LeonLeibbrandt/stm32f103-dro/kicad-B_Cu.png

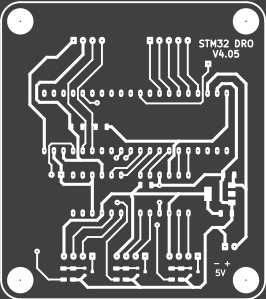
kicad-B_Cu.png
