LeonLeibbrandt/stm32f103-dro/3dobjects/150mm/CaliperHead.FCStd

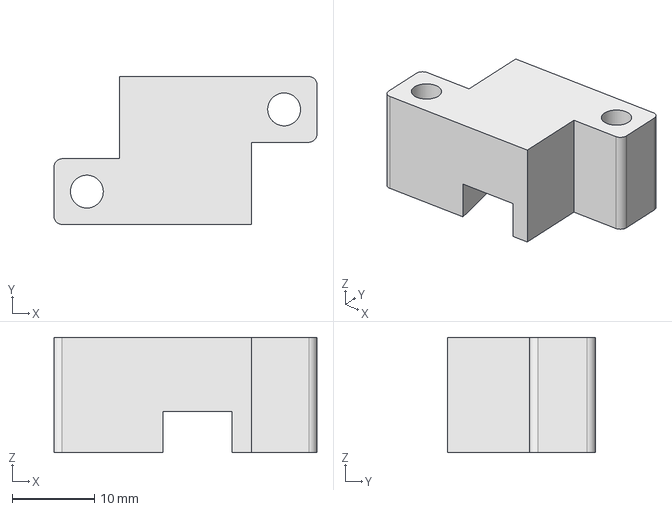
[picture p2: CAD file, 2023-06-25]
3dobjects/150mm/CaliperHead.FCStd
32.0 x 18.0 x 14.0 mm
