LeonLeibbrandt/stm32f103-dro/3dobjects/200mm/CaliperHeads.FCStd

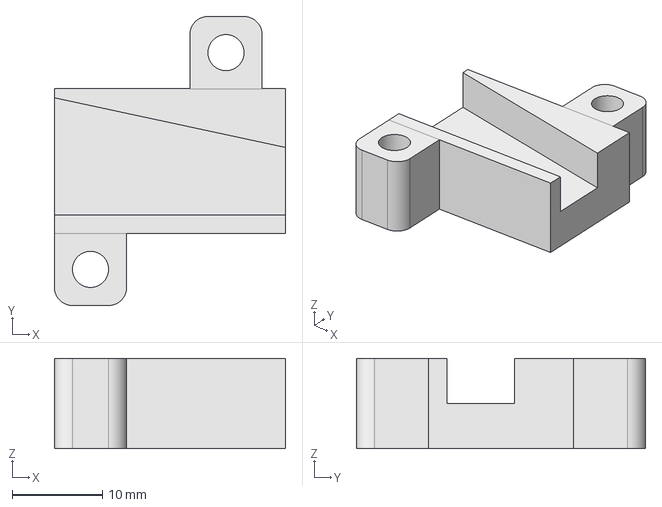
[picture p3: CAD file, 2022-05-27]
3dobjects/200mm/CaliperHeads.FCStd
25.6 x 32.0 x 10.0 mm
