LeonLeibbrandt/stm32f103-dro/3dobjects/300mm/CaliperHeads.FCStd

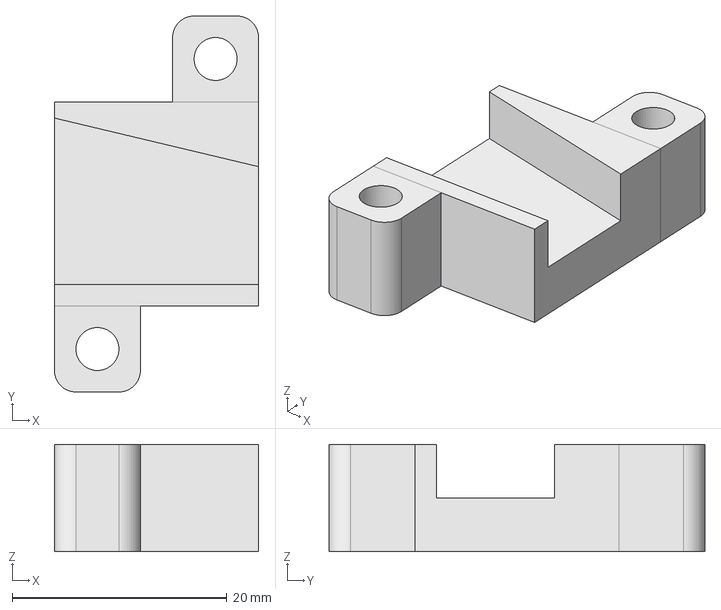
[picture p4: CAD file, 2022-05-27]
3dobjects/300mm/CaliperHeads.FCStd
19.0 x 35.0 x 10.0 mm
