LeonLeibbrandt/stm32f103-dro/3dobjects/box/dro.FCStd

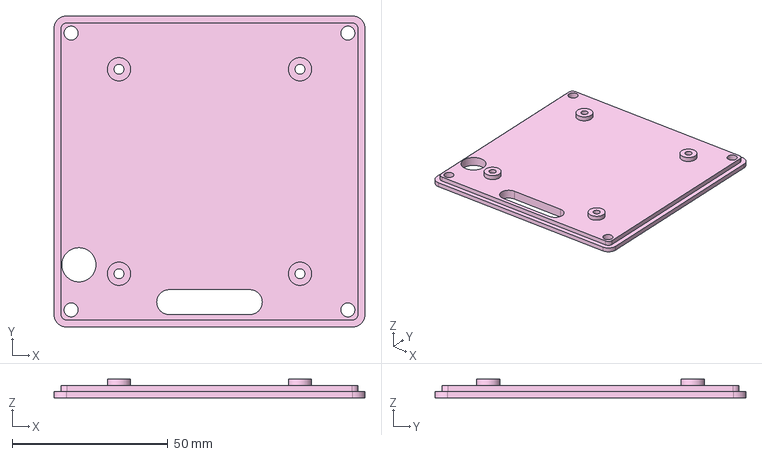
[picture p5: CAD file, 2022-11-13]
3dobjects/box/dro.FCStd
100.0 x 100.0 x 6.00 mm
