LeonLeibbrandt/stm32f103-dro/kicad/3dmodels/Tactile Push Button THT 12x12mm H8.50mm (Würth 430476085716).stp

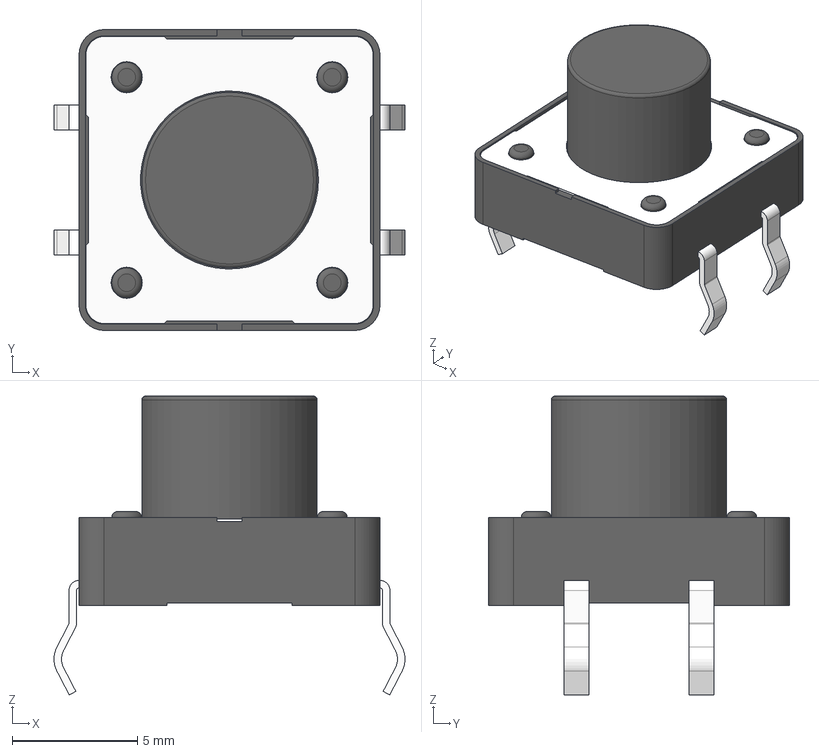
[picture p6: CAD file, 2022-05-27]
kicad/3dmodels/Tactile Push Button THT 12x12mm H8.50mm (Würth 430476085716).stp
14.0 x 12.0 x 11.9 mm
