LeonLeibbrandt/stm32f103-dro/3dobjects/150mm/CaliperHolder.FCStd

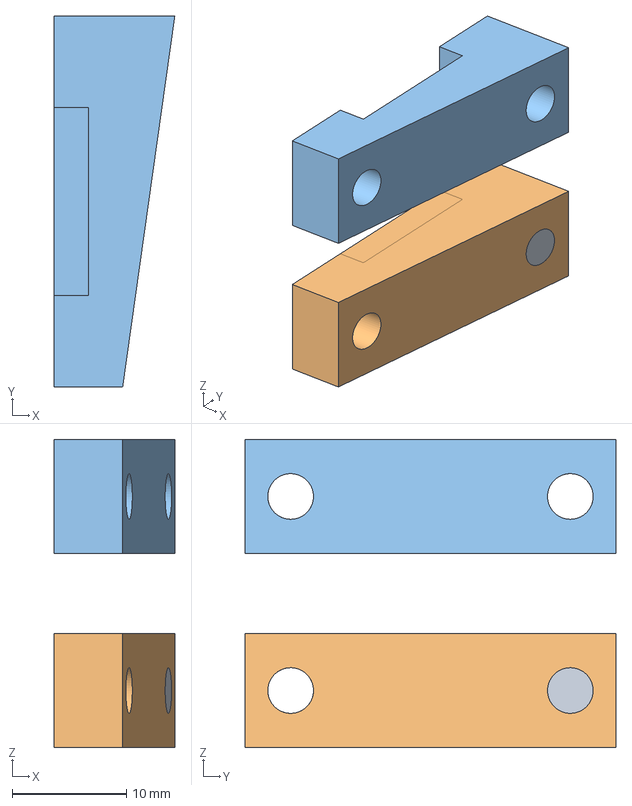
[picture p7: CAD file, 2023-06-25]
3dobjects/150mm/CaliperHolder.FCStd
10.6 x 32.5 x 27.0 mm
