LeonLeibbrandt/stm32f103-dro/3dobjects/200mm/CaliperMount.FCStd

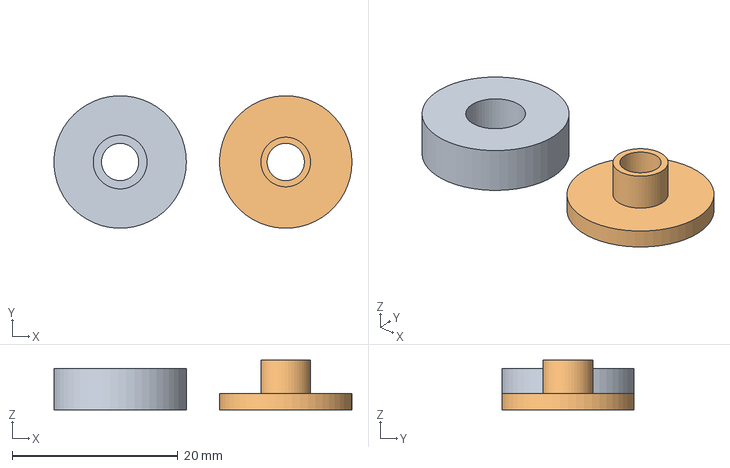
[picture p8: CAD file, 2022-05-27]
3dobjects/200mm/CaliperMount.FCStd
36.0 x 16.0 x 6.00 mm
Cap
