LeonLeibbrandt/stm32f103-dro/3dobjects/300mm/Caliper300mmEndCap.FCStd

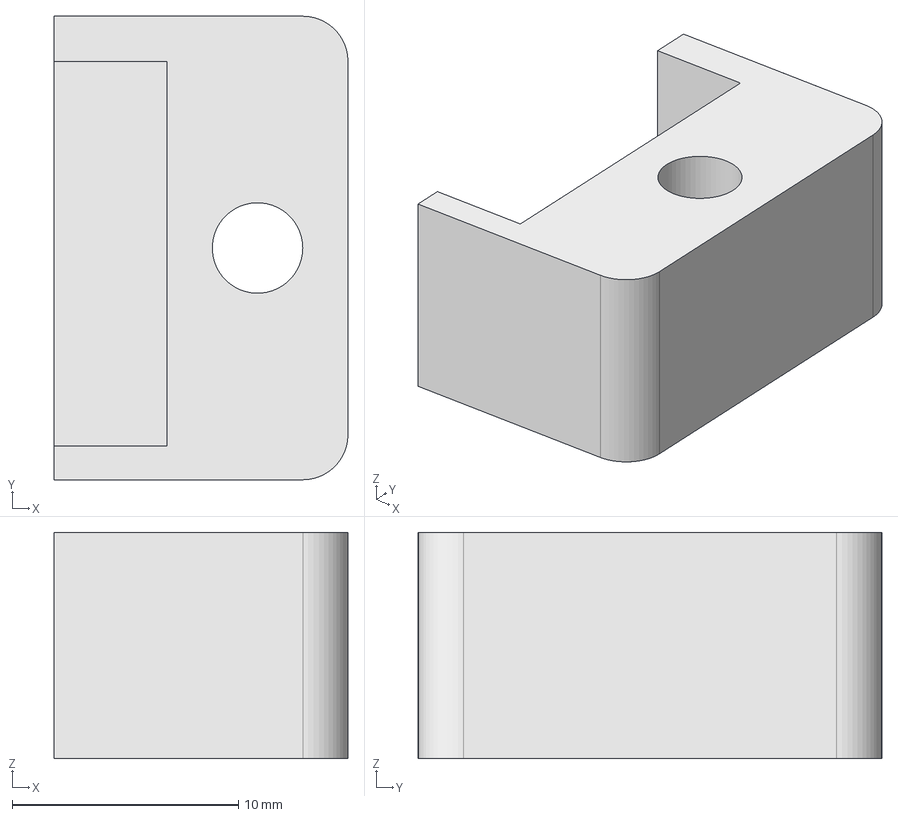
[picture p9: CAD file, 2022-05-27]
3dobjects/300mm/Caliper300mmEndCap.FCStd
13.0 x 20.5 x 10.0 mm
