LeonLeibbrandt/stm32f103-dro/3dobjects/150mm/CaliperHeads.FCStd

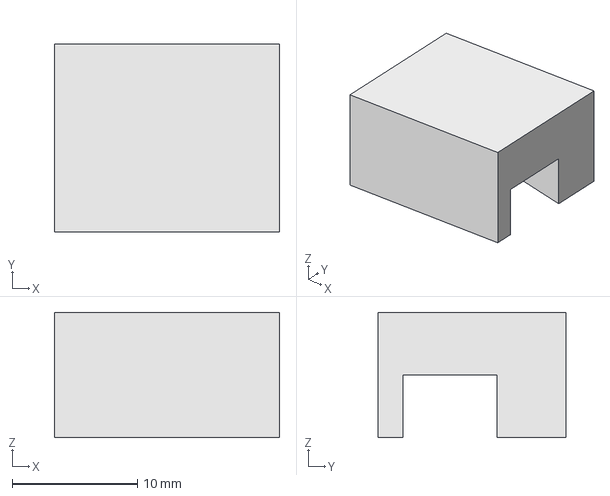
[picture p10: CAD file, 2022-05-27]
3dobjects/150mm/CaliperHeads.FCStd
18.0 x 15.0 x 10.0 mm
