LeonLeibbrandt/stm32f103-dro/kicad/main/kicad.kicad_pcb

## KiCad design kicad/main/kicad.kicad_pcb (2024-09-24)

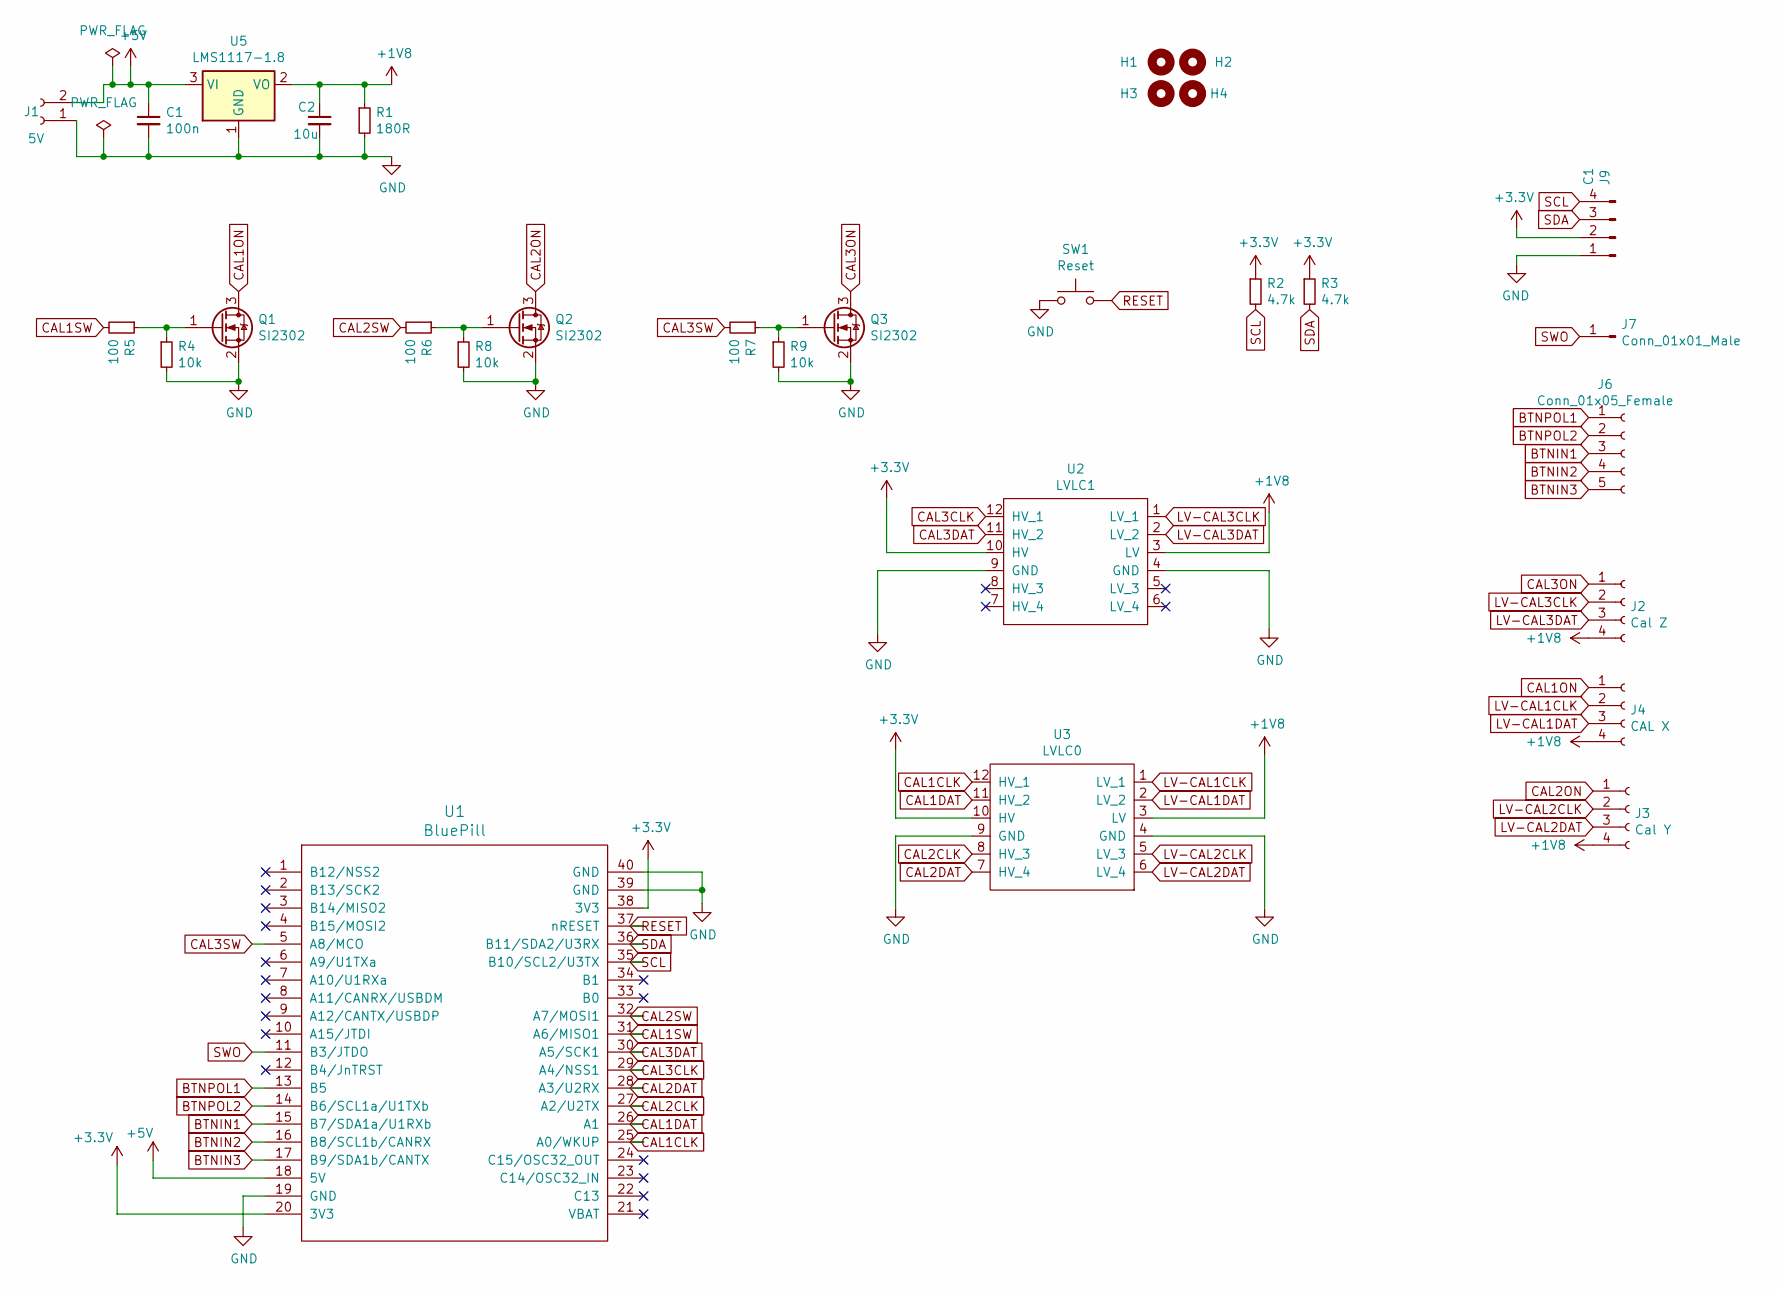
[picture p11: schematic kicad.kicad_sch]

Parts:
C1: 100n; C_1206_3216Metric
C2: 10u; C_1206_3216Metric
H1, H2, H3, H4: MountingHole; MountingHole_3.5mm_Pad
J1: 5V; JST_XH_B2B-XH-A_1x02_P2.50mm_Vertical
J2: Cal Z; JST_XH_B4B-XH-A_1x04_P2.50mm_Vertical
J3: Cal Y; JST_XH_B4B-XH-A_1x04_P2.50mm_Vertical
J4: CAL X; JST_XH_B4B-XH-A_1x04_P2.50mm_Vertical
J6: Conn_01x05_Female; JST_XH_B5B-XH-A_1x05_P2.50mm_Vertical
J7: Conn_01x01_Male; PinHeader_1x01_P2.54mm_Horizontal
J9: C1; JST_XH_B4B-XH-A_1x04_P2.50mm_Vertical
Q1, Q2, Q3: SI2302; SOT-23
R1: 180R; R_1206_3216Metric
R2, R3: 4.7k; R_1206_3216Metric
R4, R8, R9: 10k; R_1206_3216Metric
R5, R6, R7: 100; R_1206_3216Metric
SW1: Reset; PinHeader_1x02_P2.54mm_Vertical
U1: BluePill; bluepill
U2: LVLC1; levelconverter
U3: LVLC0; levelconverter
U5: LMS1117-1.8; SOT-223-3_TabPin2

Connections:
+1V8: C2.1, J2.4, J3.4, J4.4, R1.1, U2.3 (LV), U3.3 (LV), U5.2 (VO)
+3V3: J9.2, R2.1, R3.1, U1.20 (3V3), U1.38 (3V3), U2.10 (HV), U3.10 (HV)
+5V: C1.1, J1.2, U1.18 (5V), U5.3 (VI)
BTNIN1: J6.3, U1.15 (B7/SDA1a/U1RXb)
BTNIN2: J6.4, U1.16 (B8/SCL1b/CANRX)
BTNIN3: J6.5, U1.17 (B9/SDA1b/CANTX)
BTNPOL1: J6.1, U1.13 (B5)
BTNPOL2: J6.2, U1.14 (B6/SCL1a/U1TXb)
CAL1CLK: U1.25 (A0/WKUP), U3.12 (HV_1)
CAL1DAT: U1.26 (A1), U3.11 (HV_2)
CAL1ON: J4.1, Q1.3 (D)
CAL1SW: R5.2, U1.31 (A6/MISO1)
CAL2CLK: U1.27 (A2/U2TX), U3.8 (HV_3)
CAL2DAT: U1.28 (A3/U2RX), U3.7 (HV_4)
CAL2ON: J3.1, Q2.3 (D)
CAL2SW: R6.2, U1.32 (A7/MOSI1)
CAL3CLK: U1.29 (A4/NSS1), U2.12 (HV_1)
CAL3DAT: U1.30 (A5/SCK1), U2.11 (HV_2)
CAL3ON: J2.1, Q3.3 (D)
CAL3SW: R7.2, U1.5 (A8/MCO)
GND: C1.2, C2.2, J1.1, J9.1, Q1.2 (S), Q2.2 (S), Q3.2 (S), R1.2, R4.2, R8.2, R9.2, SW1.1, U1.19 (GND), U1.39 (GND), U1.40 (GND), U2.4 (GND), U2.9 (GND), U3.4 (GND), U3.9 (GND), U5.1 (GND)
LV-CAL1CLK: J4.2, U3.1 (LV_1)
LV-CAL1DAT: J4.3, U3.2 (LV_2)
LV-CAL2CLK: J3.2, U3.5 (LV_3)
LV-CAL2DAT: J3.3, U3.6 (LV_4)
LV-CAL3CLK: J2.2, U2.1 (LV_1)
LV-CAL3DAT: J2.3, U2.2 (LV_2)
unnamed: Q1.1 (G), R4.1, R5.1
unnamed: Q2.1 (G), R6.1, R8.1
unnamed: Q3.1 (G), R7.1, R9.1
RESET: SW1.2, U1.37 (nRESET)
SCL: J9.4, R2.2, U1.35 (B10/SCL2/U3TX)
SDA: J9.3, R3.2, U1.36 (B11/SDA2/U3RX)
SWO: J7.1, U1.11 (B3/JTDO)

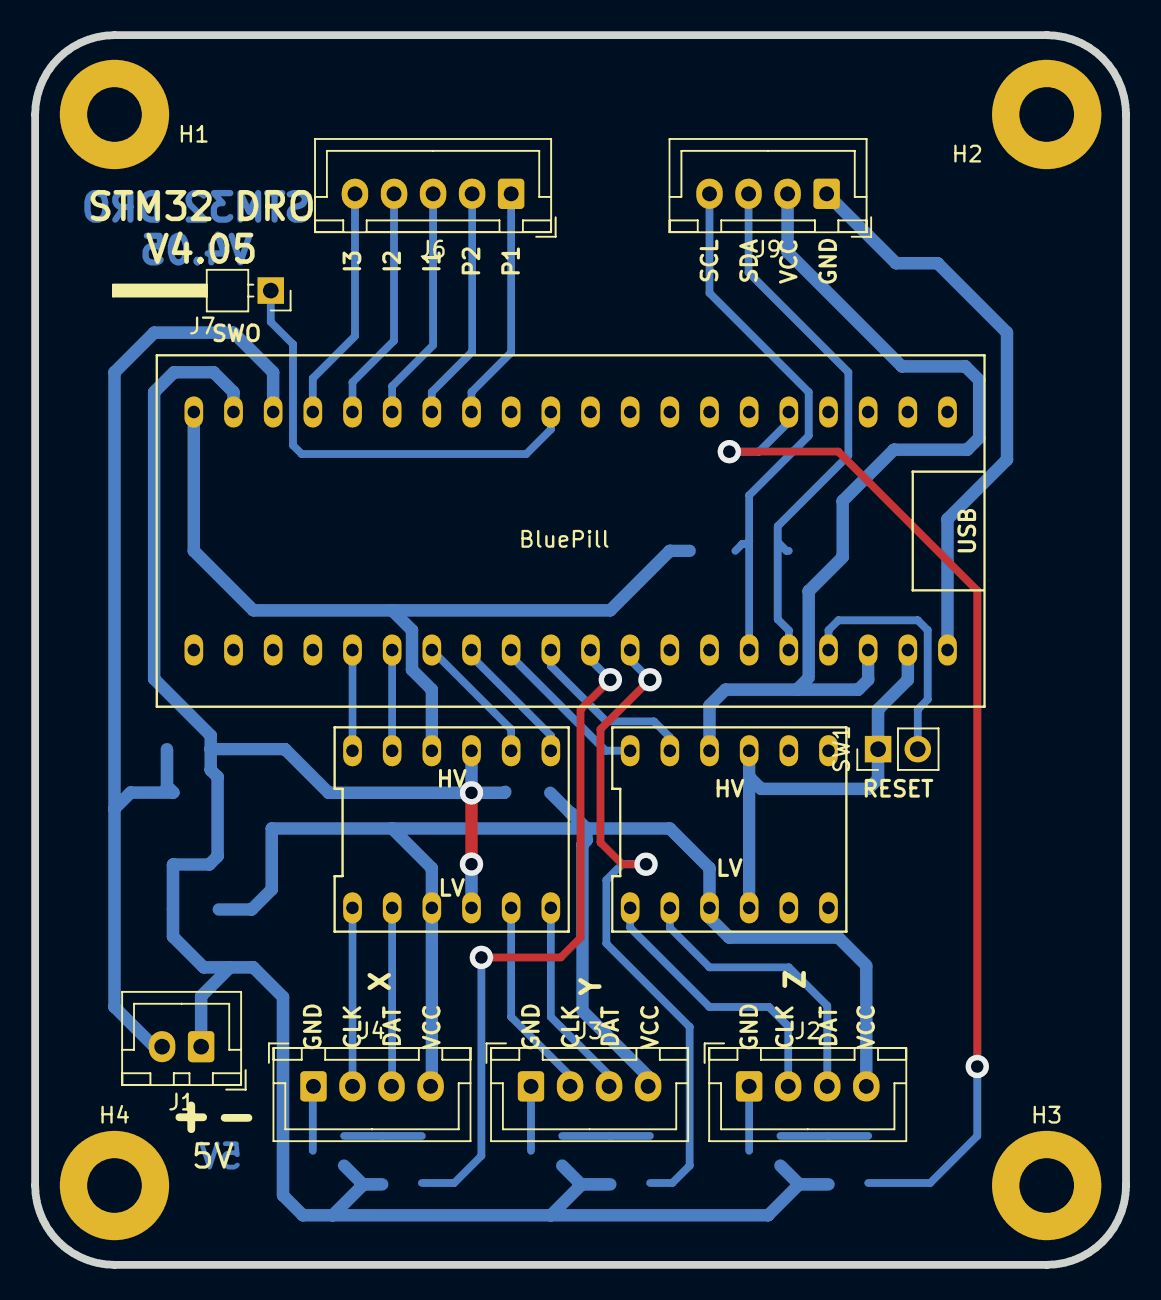
[picture p12: board kicad.kicad_pcb from above]

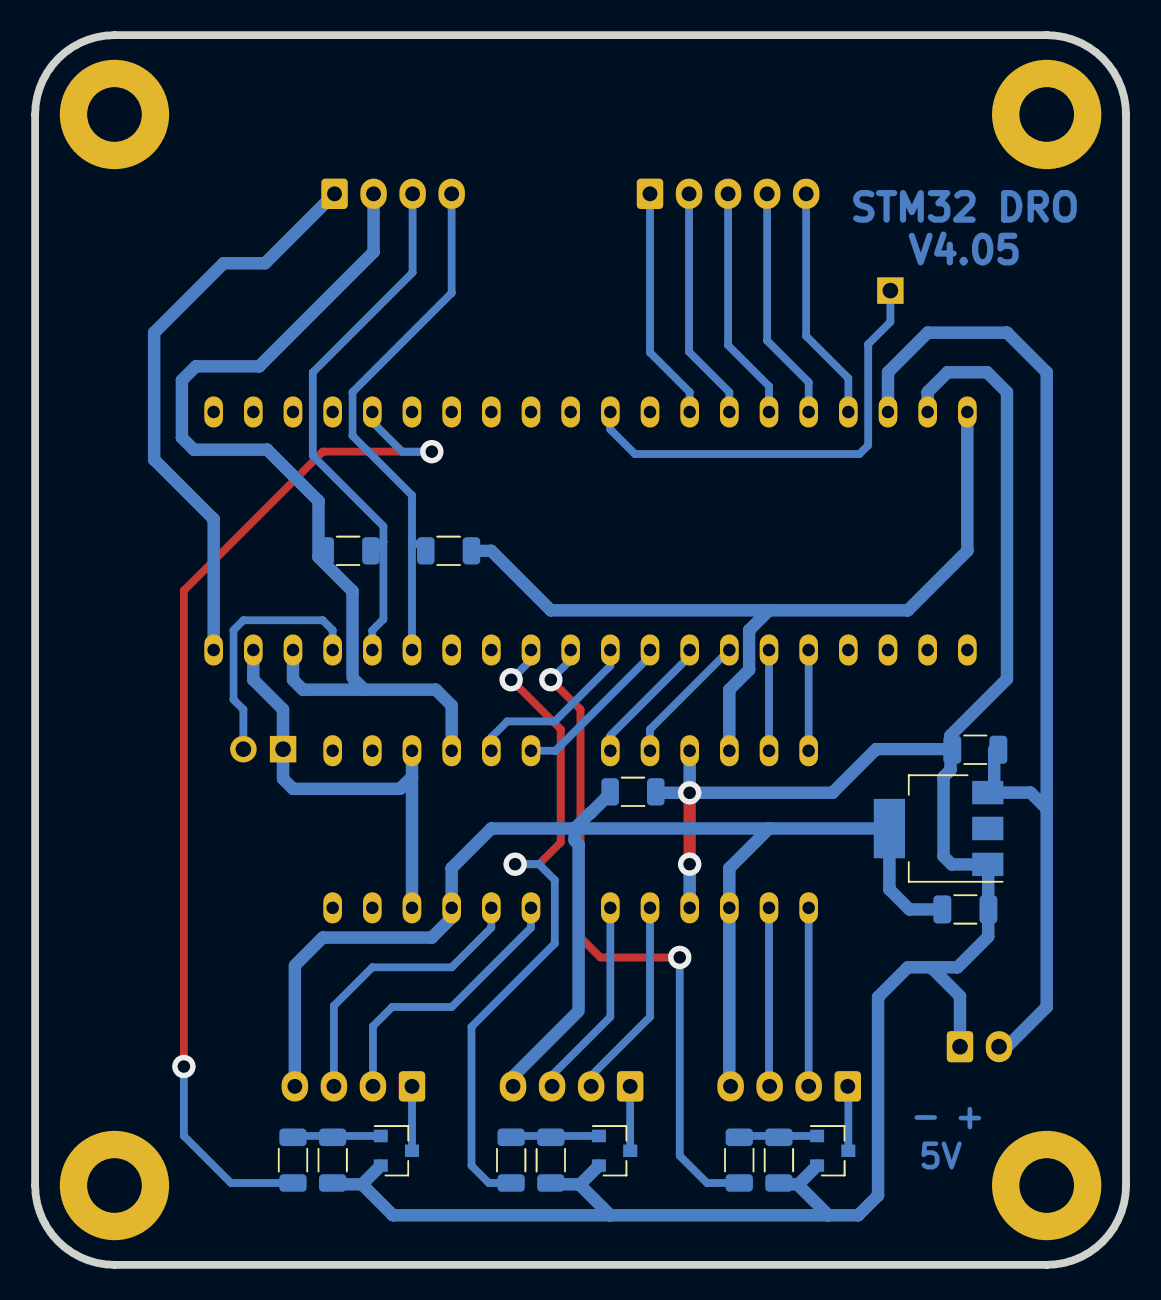
[picture p13: board kicad.kicad_pcb from below]

Board: 2 copper layers, 69.8 x 78.7 mm, 30 parts (15 on the bottom side), 34 nets.
