LeonLeibbrandt/stm32f103-dro/kicad/interface/interface.kicad_pcb

## KiCad design kicad/interface/interface.kicad_pcb (2022-05-27)

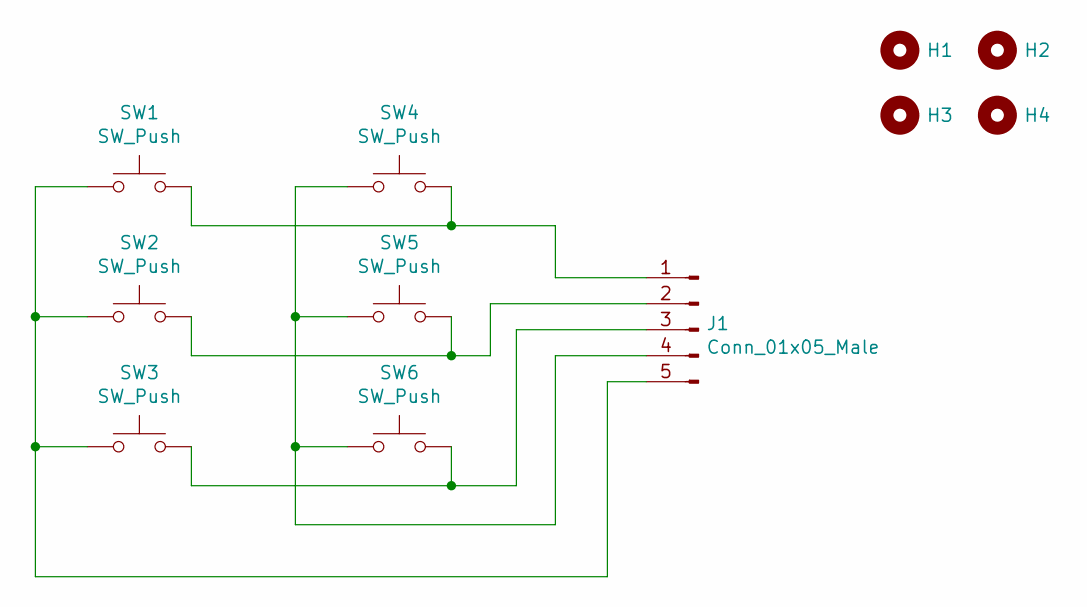
[picture p14: schematic interface.kicad_sch]

Parts:
H1, H2, H3, H4: MountingHole; MountingHole_3mm_Pad
J1: Conn_01x05_Male; JST_XH_B5B-XH-A_1x05_P2.50mm_Vertical
SW1, SW2, SW3, SW4, SW5, SW6: SW_Push; SW_PUSH-12mm

Connections:
unnamed: J1.1, SW1.2, SW4.2
unnamed: J1.2, SW2.2, SW5.2
unnamed: J1.3, SW3.2, SW6.2
unnamed: J1.4, SW4.1, SW5.1, SW6.1
unnamed: J1.5, SW1.1, SW2.1, SW3.1

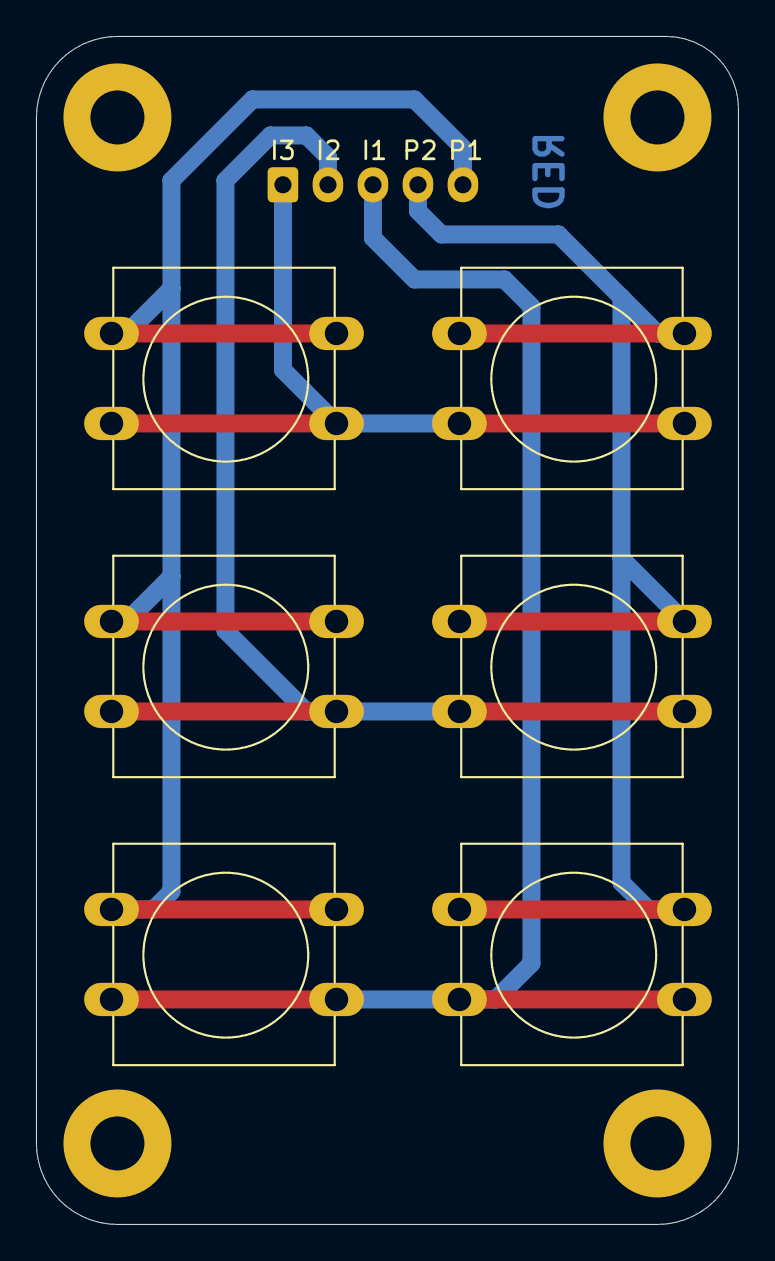
[picture p15: board interface.kicad_pcb from above]

Board: 2 copper layers, 39.0 x 66.0 mm, 11 parts (1 on the bottom side), 5 nets.
