LeonLeibbrandt/stm32f103-dro/code/Core/Src/main.c

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
/* Includes ------------------------------------------------------------------*/
#include "main.h"
#include "i2c.h"
#include "tim.h"
#include "gpio.h"

/* USER CODE BEGIN Includes */
#include <stdio.h>
#include "../../DRO/Inc/ssd1306_i2c.h"
#include "../../DRO/Inc/buttons.h"
#include "../../DRO/Inc/calipers.h"
/* USER CODE END Includes */


void SystemClock_Config(void);
/**
  * @brief  The application entry point.
  * @retval int
  */
int main(void)
{

  /* MCU Configuration--------------------------------------------------------*/

  /* Reset of all peripherals, Initializes the Flash interface and the Systick. */
  HAL_Init();

  /* USER CODE BEGIN Init */
  HAL_PWR_DisableWakeUpPin(PWR_WAKEUP_PIN1);
  /* USER CODE END Init */

  /* Configure the system clock */
  SystemClock_Config();

  /* Initialize all configured peripherals */
  MX_GPIO_Init();
  MX_I2C2_Init();
  MX_TIM2_Init();
  /* USER CODE BEGIN 2 */
  ssd1306_init();
  HAL_Delay(1000);
  ssd1306_clear();
  ssd1306_refresh();
  HAL_GPIO_WritePin(LED_GPIO_Port, LED_Pin, GPIO_PIN_RESET);
  bool changed = false;

  // Disable interrupts to start the calipers staggered
  DisableCaliperInterrupts();
  HAL_GPIO_WritePin(CAL1SW_GPIO_Port, CAL1SW_Pin, GPIO_PIN_SET);
  calipers[0]->last = HAL_GetTick();

  // printf("Started X\n");

  HAL_Delay(30);
  HAL_GPIO_WritePin(CAL2SW_GPIO_Port, CAL2SW_Pin, GPIO_PIN_SET);
  calipers[1]->last = HAL_GetTick();

  // printf("Started Y\n");

  HAL_Delay(30);
  HAL_GPIO_WritePin(CAL3SW_GPIO_Port, CAL3SW_Pin, GPIO_PIN_SET);
  calipers[2]->last = HAL_GetTick();

  // printf("Started Z\n");

  EnableCaliperInterrupts();

  buttons_setup();
  HAL_TIM_Base_Start_IT(&htim2);

  /* USER CODE END 2 */

  /* Infinite loop */
  /* USER CODE BEGIN WHILE */
  while (1)
  {
	  changed = false;
	  for (int i = 0; i < 3; i++)
	  {
		  changed |= ssd1306_drawhmm(i, calipers[i]);
	  }
	  if (changed)
		  ssd1306_refresh();
    /* USER CODE END WHILE */

    /* USER CODE BEGIN 3 */

	  /*
	  pins = HAL_GPIO_ReadPin(GPIOB, BUTTIN0_Pin | BUTTIN1_Pin | BUTTIN2_Pin);
	  poll = button_poll;
	  check_buttons(pins, poll, BUTTIN2_Pin, 0);
	  check_buttons(pins, poll, BUTTIN1_Pin, 1);
	  check_buttons(pins, poll, BUTTIN0_Pin, 2);
	*/
  }
  /* USER CODE END 3 */
}

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
