LeonLeibbrandt/stm32f103-dro/(commit log)

2022-05-27 Added 3d models for kicad
    [Tactile Push Button THT 12x12mm H8.50mm (Würth 430476085716).stp, interface.kicad_pcb, kicad.kicad_pcb]
2022-11-13 Updated to CubeIDE 1.10.0
    [dro.FCStd, kicad.kicad_pcb]
2024-09-24 Update With only STMCubeMX
    [kicad.kicad_pcb, kicad.kicad_sch]
